awesomeshield/Awesome-Shield-PCB/README.md

# Awesome Shield PCB

This repo is for Awesome Shield hardware development.

## Branches

The branch `unusedVariants` is used to retain version history of variants that have been deprecated.
