awesomeshield/Awesome-Shield-PCB/26fd495.brd.png

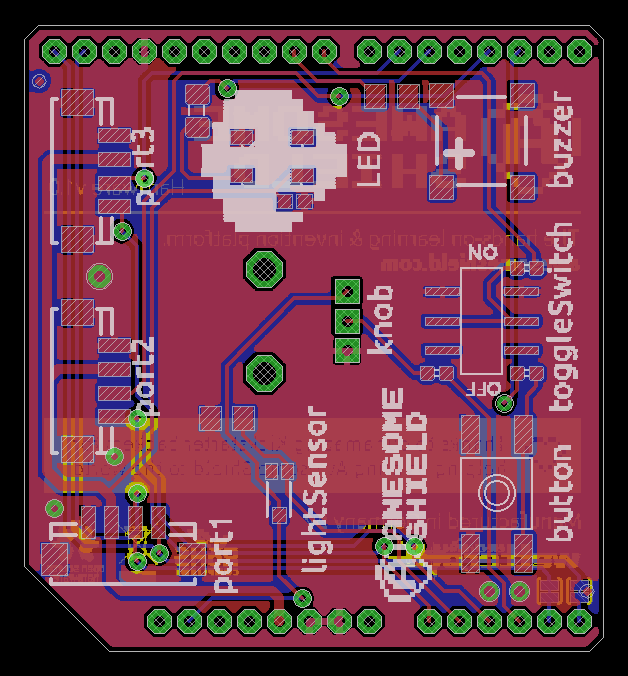
26fd495.brd.png
