awesomeshield/Awesome-Shield-PCB/26fd495.sch.png

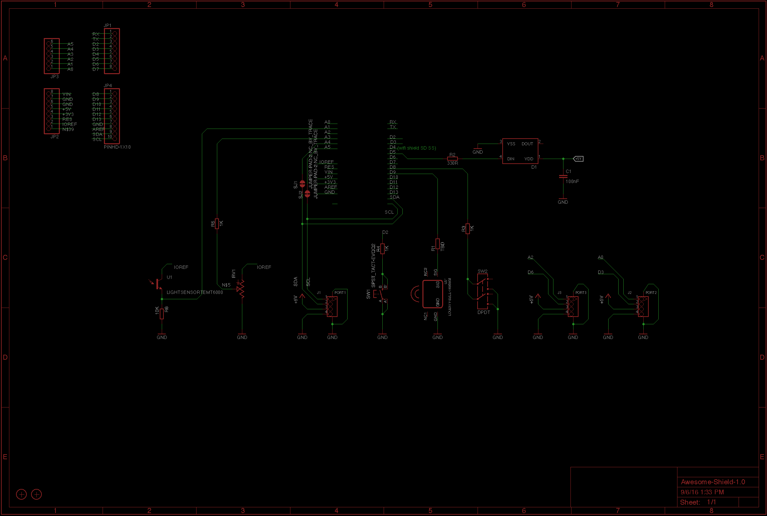
26fd495.sch.png
