awesomeshield/Awesome-Shield-PCB/4577046.brd.png

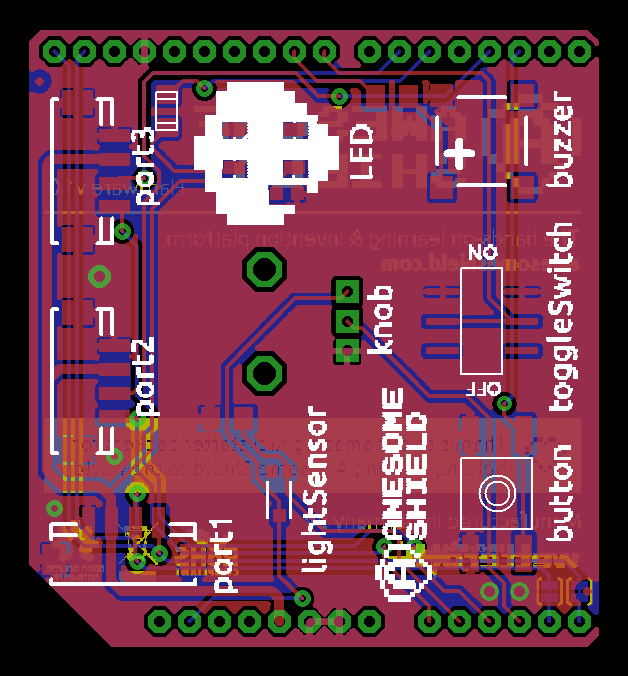
4577046.brd.png
