awesomeshield/Awesome-Shield-PCB/4577046.sch.png

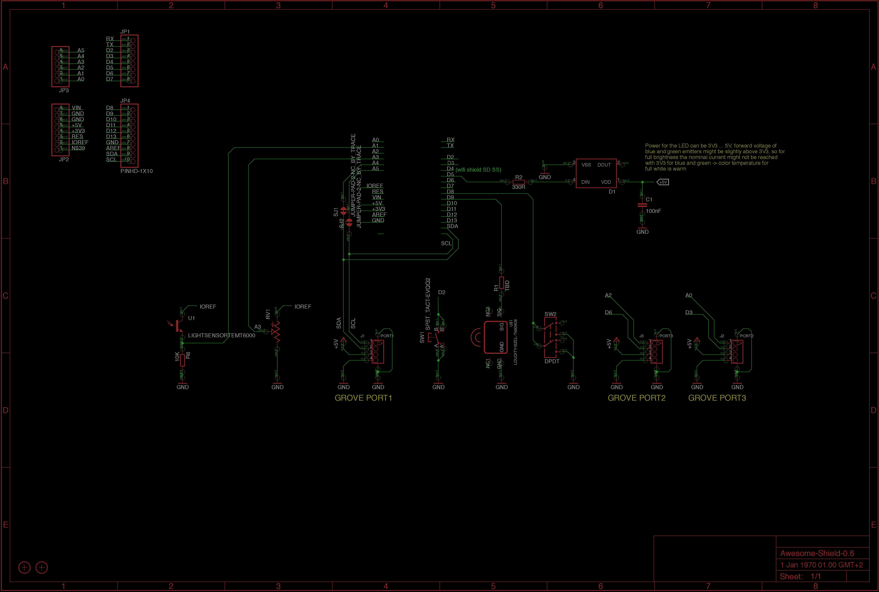
4577046.sch.png
