awesomeshield/Awesome-Shield-PCB/7615891.brd.png

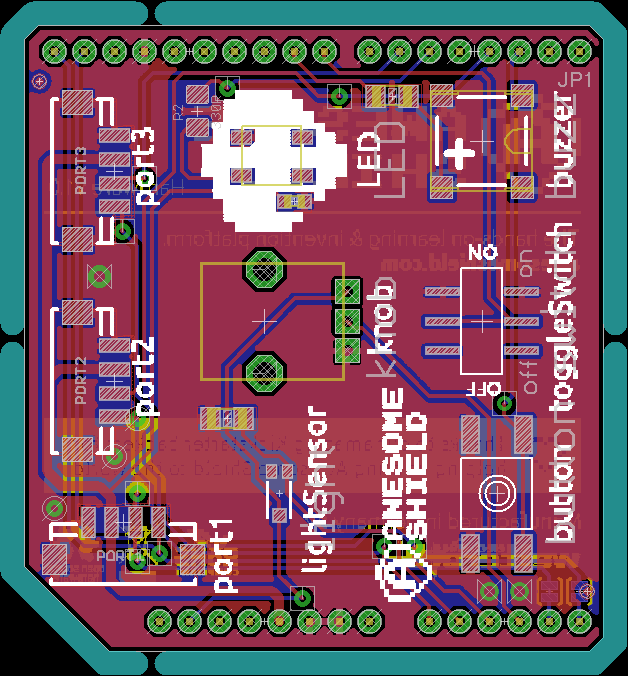
7615891.brd.png
