awesomeshield/Awesome-Shield-PCB/(threads)

Thread 1 (2015-05-11):

Change via shape to round

aShure, 2015-05-11:

cwjpalmer, 2015-05-12:
I've been using a 1mm radius miter to do this. Is that a reasonable turning radius?

aShure, 2015-05-13:
I was thinking about the via pads :) They seem to be squared. You can change the via shape of all the vias simultaneously with the command line.

cwjpalmer, 2015-05-14:
Right! Thanks for clarifying. Somehow I read 'via' as 'trace'. Oops. I'll make sure all the traces are normal straight edges on 45 degree turns, and make sure the vias are all round :-)

cwjpalmer, 2015-05-19:
done.

Closed 2015-05-19.

Thread 2 (2015-05-11):

Add second row of headers right next to the existing ones, with an offset of 100mil

aShure, 2015-05-11:

cwjpalmer, 2015-05-12:
What's the purpose of the headers? Should they be 'straight' aligned, or locking?

aShure, 2015-05-13:
I suggest straight ones, they can then be used to directly solder onto the shield for prototyping OR to populate female headers to accept another shield, while shipping out the product with sturdy and presoldered male headers. Male headers are cheaper and more robust than long stack male-female headers.

cwjpalmer, 2015-05-19:
We're actually leaning towards shipping with male headers, and not including a second row of headers. The rationale is:
- male headers make the components more physically accessible
- the vast majority of our users won't want to solder anything
- if people want to connect up additional components, they can always attach jumpers to the pins on the grove ports
- we want to keep the design simple, and avoid confusing people with stuff they don't need

Closed 2015-05-19.

Thread 3 (2015-05-11):

Run DRC and correct spacing,ie via next to R11

aShure, 2015-05-11:

cwjpalmer, 2015-05-13:
@aShure one DRC error I'm getting a lot is Drill size, one some vias I put into the ground pours to connect them to each other (last time I made a PCB I read that it's good practice to put vias into the ground planes). I used the default drill size for vias (outer diameter=1.0064, drill=0.6).

Questions:
1) should I include vias connecting the ground pours?
2) what size is appropriate?

aShure, 2015-05-13:
Check your net classes, it could be that the power class needs bigger values (which is wrong in this application, but might be the default)

1) Yes
2) same diameter as the holes that are used for the THT headers OR a via diameter that is the maximum which is tented by common PCB manufacturers. Tented via = buried and sealed under solder mask, hole partly or fully bridged by solder mask print.

cwjpalmer, 2015-05-19:
Okay, the spacing issues and other DRC issues are fixed, except for hole sizes on vias.

I'm still looking into tented via sizes, and then I'll update via sizes and make sure the DRC settings correspond. After that, the DRC should be happy :-)

cwjpalmer, 2015-05-20:
I heard back from one potential manufacturer (Seeed) and their max tented hole size is D=0.6mm. Coincidentally, that's what the hole size is currently.

@aShure Could you let me know what German manufacturer you're thinking about using for the first run of 3-4 test PCBS? I'll contact them to see what their max tented via size is. If it's smaller than D=0.6mm, I'll adjust the layout accordingly. If it's D>=0.6mm, I'll keep the vias at D=0.6mm.

Or, if you happen to know this number off hand, that would be cool, too :-)

We're getting close!

aShure, 2015-05-20:
Okay sounds good. 0.6mm sounds big for finished hole size, so I guess it's drill diameter.. I know at least http://www.multi-circuit-boards.eu/ don't guarantee tenting over 300µm finished hole size, so that's after plating.

I suggest https://www.haka-lp.de/ for the first run, please download the DRC file from their homepage and see if everything is okay.
I think Haka have 2mm routing for free but they charge for anything smaller.

cwjpalmer, 2015-05-21:
@aShure Great!

My German is a little rough, so I want to confirm which of haka's DRU files I should use. I'm thinking "zwilling" because leo translates it as "twin". Is that right? Here are their options:

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

aShure, 2015-05-21:
haka_35_l2 and zwilling.

35µm copper, 2 layers and the budget version "zwilling" where you get a
pair of your prototype for a cheaper price if it can be processed in a
stack (hence the bigger diameter and worse tolerances, boards are
stacked and then drilled and routed - the more boards in the stack, the
lower the accuracy)

cwjpalmer, 2015-05-21:
Marvellous. Now the file nomenclature makes sense to me. Thanks for clarifying. And that's good to know about the

I'll run the two DRC sets you mentioned, and make adjustments.

cwjpalmer, 2015-05-21:
**DRC results for haka's haka_35_l2 and zwilling**

all three branches ( `master`, `CPver2`, `CPvar6` ) had two sets of issues across both DRCs:
- solderable jumpers give 9 overlap errors on layer 1
- R9,R10 square arrangement gave 6 keepout errors, as already discussed and approved in issue 11

aShure, 2015-05-28:
The DRC errors are all fine. And yes, you are correct that normal DRC settings are for untented vias. I will inquire about the tented via size.

aShure, 2015-05-28:
Can't reach Haka right now.
Set the tented via size to e.g. 0.6mm - thus the headers won't be tented, but all the vias. If the vias can't be tented in production, they will be altered automatically.

cwjpalmer, 2015-05-28:
Thanks, Alex!

Closed 2015-05-25.

Thread 4 (2015-05-13):

Check clearance for USB and power connector on Arduino motherboard, see if standard (short) male headers are suitable.

aShure, 2015-05-13:
Maybe clear route out the areas where the shield interferes with the motherboard. If possible in a pattern that gives no loss and interlocks two shields head to head, only separated with a 1mm routed path.

cwjpalmer, 2015-05-19:
My approach on this was to make the board a little smaller. Now it shouldn't overlap with the USB or power housings on an Arduino Uno. The new board layout should also work for interlocking head to head.

@aShure one question about interlocking: Right now, the board outline assumes that the centre of the router passes over the centre of the line in eagle on the board outline layer. This puts the angled section of the board outline exactly in the middle of the board, in the Y axis (as in "A" in the diagram). But I think that given the 1mm routed path, this angled section of the board outline should actually be offset by 0.5mm to correctly align 2 boards in the x-direction. Ie. it should be 0.5mm lower on the left hand board orientation, and 0.5mm higher on the right hand side board orientation, as in "B" in the diagram.

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

Does B make more sense to you, too? Are there other factors that I should account for?

aShure, 2015-05-19:
It's correct that the cnc router will ride along the middle of the drawn path as the paths middle is stored numerically as a 2d vector. It's important to choose the right size line width (1mm) for the line because that is passed to the machine as the end mill size.

To me it seems that there is no offset needed if you choose the correct line width. You can verify the design if you a 180 degree rotation around the middle of the slope - the whole board outline has got to be point symmetric around that.

cwjpalmer, 2015-05-19:
Fantastic! So it's scenario A, with the correct line width (1mm). I'll verify by rotation as you've suggested.

cwjpalmer, 2015-05-19:
I checked branch `master`, `CPver2` and `CPvar6` by rotation. They all seem good.

cwjpalmer, 2015-05-19:
@aShure when I changed the route width to 1mm, the DRC had issues with a whole bunch of spacing around the edge of the board. Many things (eg. traces) are easy to fix, but it also had problems with half the pins on the locking headers. Do you recommend that I:

A) only change the interlocking edges between boards to 1mm router width, and leave the the other sides as they were initially
B) change to non-locking headers – it seems like this would fix the problem, but I hope there's a better solution, because the locking headers will make such a big difference during assembly
C) do something else?

Here's a screen shot of A, so you can see what I mean:
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

aShure, 2015-05-19:
The DRC rules might be a tad too conservative, however, after your decision to ditch the stacking headers, it makes sense to use non locking footprints for the male headers. It's a joy to solder them, if they are plugged in another shield or mainboard. The Awesomeshield then just rests on top and is perfectly flat with no strain. So my vote would be B) :+1:

I suggest using the outline layer either on the middle of the path with 1mm width or offset to the inside about 0.5mm and then width a hairline width. In any case, use the *milling* layer and describe the contours there, stick to 1mm width, anything below 1mm as an outline is often just rejected. (some require even 2mm as it is easier to machine and more boards can be stacked!). Don't forget to add tabs, ie interruptions on the path, so that the board won't fall out and crash on the machine, but stay in place in the panel only to be separated after soldering. I suggest 0.5mm tabs at the top left, bottom left, mid right. You have to think about a layout that daisy chains and supports adjacent boards in the panel. Should I draft something to explain it further?

cwjpalmer, 2015-05-20:
Okay, Awesome! I implemented option B in the branches containing our three working versions.

Thanks for the info about the milling layer. It was completely empty. I'll fix that.

cwjpalmer, 2015-05-20:
Re: tab locations, thinking about the board being fit together in pairs, are you thinking tabs at these locations (tabs indicated by notches perpendicular to the outline)?

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

aShure, 2015-05-20:
That is an excellent variant, exactly what I had in mind! If you leave a little space towards the corners (just like you sketched), it's easier to get a clean corner after breaking them apart. Pay special attention that you don't deviate in the X axis with the vertical tabs, as they need to be daisy chained to the adjacent boards on the panel.

cwjpalmer, 2015-05-20:
okay great! so it'll look more like this:

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

aShure, 2015-05-20:
Looks perfect :+1:

cwjpalmer, 2015-05-20:
okay, routing is done, along with tabs.

Closed 2015-05-20.

Thread 5 (2015-05-13):

Place jumpers in a straight line, so they can be cut easily without damaging other traces.

aShure, 2015-05-13:

cwjpalmer, 2015-05-19:
smart!

Closed 2015-05-19.

Thread 6 (2015-05-13):

SDL, SCA, 9, 4... have redundant vias attached. Start route on the target side right away :)

aShure, 2015-05-13:

cwjpalmer, 2015-05-19:
Thanks for the tip! I had always started traces from headers on the top layer. They're a little more strategic now :-)

Closed 2015-05-19.

Thread 8 (2015-05-13):

Route potentiometer to IOREF instead of a fixed power rail

aShure, 2015-05-13:
That is the actual purpose of IOREF, a value of 3.3V won't be a full ADC reading on a 5V Arduino if the pot is fixed to 3.3V max.

aShure, 2015-05-13:
Same might make sense for other parts..

cwjpalmer, 2015-05-19:
I think I should do the same with the thermistor. I'm not sure about the photodiode, though. What do you think @aShure ?

aShure, 2015-05-19:
Yes. Simply all devices that feed into the ADC should have the same voltage output that the controller runs on. Less than the controller's voltage is possible too, but one would lose resolution and a scale in software is needed then.

cwjpalmer, 2015-05-19:
great! I opened a new issue for the other ADC components

Closed 2015-05-19.

Thread 10 (2015-05-19):

A3 is connected to GND instead of potentiometer

aShure, 2015-05-19:
check middle pin of potentiometer, it's NC right now.

cwjpalmer, 2015-05-20:
good catch! I connected A3 to the middle pin of the pot on `master` , `CPver2` , `CPvar6`

@cwjpalmer: remember to update this on `issue11` if merging that branch into main

cwjpalmer, 2015-05-20:
@aShure do you think I should connect the large mounting holes to GND, or leave them as NC?

aShure, 2015-05-20:
Connecting to GND is fine, use thermals to make it easy to solder - lots of thermal mass.
On 20/05/2015 4:14 pm, Chris Palmer <notifications@github.com> wrote:@aShure do you think I should connect the large mounting holes to GND, or leave them as NC?

—Reply to this email directly or view it on GitHub.

cwjpalmer, 2015-05-20:
@aShure I'm having a bit of a tough time getting eagle to connect those pads to the GND net. Is there any reason not to leave them NC (as they are now, and as the part in the Sparkfun library is configured)? If there's nothing bad about leaving them as is, I'll do that.

aShure, 2015-05-20:
No problem just leave them like that. FYI for future endeavors: If you
can't manage to connect the pin in the library part, you can always
route a wire with the GND net (use the name command) to a pin manually
as a hack and ignore the DRC error for that pin then.

cwjpalmer, 2015-05-21:
Great! I'll leave it, and that's a really good trick to know. Thanks for sharing the tip :-)

Closed 2015-05-21.

Thread 11 (2015-05-19):

rearrange R3,4 and R9,10 so that one single part can be used too

aShure, 2015-05-19:
Two resistors can be bridged if they are placed in a way that all of their four pads are in a regular square pattern. That way one can either use two in series or just one part, with half the resistance.

cwjpalmer, 2015-05-20:
I think I understand. I'll give it a try, and you can let me know if I did it correctly.

cwjpalmer, 2015-05-20:
Okay, I gave this a try in the branch `issue11` https://github.com/cwjpalmer/Awesome-Shield-PCB-0.5/tree/issue11

@aShure Is this what you had in mind? If so, let me know and I'll merge this back into master, and make similar changes in the other two working variants.

Some things that I noticed that might be problematic:
1. the spacing of the 0603 resistors (R9,10) now violates the DRC (in order to put the pads in the square arrangement)
2. the pads for the resistors aren't square. So although they're arranged in a square, if you tried to solder a single resistor between the two sets of pads (to avoid using 2 in series) I think that part of the resistor would land on solder mask. You can see what I mean by copying a resistor, rotating it 90 degrees, and holding over the two pads, where you would solder it.

aShure, 2015-05-20:
I am sure that the 1206 resistors will fit either way even if the pad is designed for reflow and not square. I guess you're onto something with the 0603 pads being not square. Does the DRC complain about the tRestrict layer with the 0603 parts or is it something else?
On 20/05/2015 12:56 pm, Chris Palmer <notifications@github.com> wrote:Okay, I gave this a try in the branch issue11 https://github.com/cwjpalmer/Awesome-Shield-PCB-0.5/tree/issue11

@aShure Is this what you had in mind? If so, let me know and I'll merge this back into master, and make similar changes in the other two working variants.

Some things that I noticed that might be problematic:
1. the spacing of the 0603 resistors (R9,10) now violates the DRC (in order to put the pads in the square arrangement)
2. the pads for the resistors aren't square. So although they're arranged in a square, if you tried to solder a single resistor between the two sets of pads (to avoid using 2 in series) I think that part of the resistor would land on solder mask. You can see what I mean by copying a resistor, rotating it 90 degrees, and holding over the two pads, where you would solder it.

—Reply to this email directly or view it on GitHub.

cwjpalmer, 2015-05-20:
That's great to know about the 1206 resistors. About the 0603 ones: the DRC complains about the tKeepout layer (39). Here's a screenshot:

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

aShure, 2015-05-20:
That's enough space for my taste, I did closer than that with Avoccado°.
The 0603 wouldn't be assembled manually anyways. One might push R9 away
with the tweezers while setting R10 with manual placement.

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

cwjpalmer, 2015-05-20:
Fantastic! So then it seems like I should incorporate what you see above (the resistor layout changes made in branch `issue11` into the 3 working variants. Does that makes sense to you? Currently, the square resistor layout is only present on branch `issue11`.

aShure, 2015-05-20:
Sure.
When I had a look at the branches it was not clear to me what the
differences are. Mind you I only took a quick glance at the
repositories, the branch names or READMEs where not explanatory to me. I
think you might be doing redundant work if you alter all branches
separately and might be faster off with sticking to one or two.

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

cwjpalmer, 2015-05-20:
Ya, I don't think I'm in a very efficient workflow. The three branches (master, CPver2, CPvar6) are three different layouts so that we can try different possibilities for UX with components in different places. I should have done one version, got you to check it, fixed all this stuff we're working through now, and then created the variants, I think. Now I know for next time :-)

cwjpalmer, 2015-05-20:
okay, all three variants now have the right resistor layouts for the R3,4,9,10

Closed 2015-05-20.

Thread 12 (2015-05-20):

Add missing data sheets

cwjpalmer, 2015-05-20:
they're all linked in the part packages, but should be in the `/datasheets` directory as PDFs

cwjpalmer, 2015-05-29:
I'm working on the BOM on octopart:
https://octopart.com/bom-lookup/NXcyO8GW

Datasheets are included there.

Closed 2015-05-29.

Thread 13 (2015-05-20):

Add fiducials

aShure, 2015-05-20:

aShure, 2015-05-22:
nudge the fiducials onto the grid, micro fiducials should align with the components' mid points. This is unresolved as of now, as some components are not placed on the grid.

aShure, 2015-05-22:
correct placement shall be finished by @cwjpalmer :-)

cwjpalmer, 2015-05-23:
will do!

cwjpalmer, 2015-05-23:
@aShure just to clarify, can you please confirm or correct this stuff? :
1. Macro fiducials should be on mm grid, near where you put them
2. Micro fiducials should be on mm grid, at midpoints of components
2b. Question: do only SMD / machine placed components need micro fiducials?
3. Should fiducials not overlap with silkscreen, or does that matter?

aShure, 2015-05-23:
1. Yes
2. Local component fiducials are not always necessary, but as there's so much space I placed them at the odd shaped components. Midpoint or one edge or three outer edges are common practice.
None of the components actually need them on this board.
Yes, metric grid please when possible - most probably that will not be the case for the mid point.

Fiducials should be free of silkscreen and solder mask, just bare copper with an annulus of nothing around them, the more space the better.

cwjpalmer, 2015-05-23:
Thanks! That was really clear and really helpful :-)

cwjpalmer, 2015-05-23:
Okay, I think it's done correctly in commit `7b772e0cbf31359f01a4ac244fdb73c1b373331e`

Closed 2015-05-23.

Thread 14 (2015-05-22):

Toggle Switch Pads

cwjpalmer, 2015-05-22:
@aShure I added 1mm to the outside edges of the toggle switch pads to make hand soldering easier. Initially the pads were exactly the same as the landing area of the feet. Do you think this will be okay for reflow, in terms of surface tension pull to one side or the other if there's an uneven heat distribution?

aShure, 2015-05-28:
It will be if you remove the thermals from the pads (uncheck Thermals at the part level) and route the GND wires manually, normal to the pads

aShure, 2015-05-28:
I just tried that and reversed it again. I think it doesn't make a difference at all because of the soldermask surrounding all the pads.

Closed 2015-05-28.

Thread 15 (2015-05-22):

Use vector font to give reliable result after gerber renderings

aShure, 2015-05-22:

cwjpalmer, 2015-05-23:
fixed in commit  `90f41782846afeb44a30a8f5622f74edbecd028e`

Closed 2015-05-23.

Thread 16 (2015-05-22):

fix milling layer to new lower real estate outline

aShure, 2015-05-22:

cwjpalmer, 2015-05-23:
done in commit `d52753dfb987454f5debca608f7b1bc4a614aa07`

Closed 2015-05-23.

Thread 19 (2015-05-24):

height should be 53 or 52, makes it easier to panelize

aShure, 2015-05-24:

aShure, 2015-05-24:
width should be reduced to 49, there's redundant space on both sides. I would take it away from the right side.
Just an example:
with a board spacing of 1mm and a width of 100mm per panel, the board better be less than 49.5mm. For a 2mm router bit, it would need to be no bigger than 49mm. If scaling up to more than just two boards in a row, each iteration should occupy no more than a 50mm including the milling bit width.

There might be space for 48mm..

cwjpalmer, 2015-05-25:
height is at 53mm, board outline is on mm grid as of commit `d2fe7ea03bfe87debf3c3968f5a6bcddb1743020`

cwjpalmer, 2015-05-25:
adjusted board width to 49mm in commit `23dbb87129958a432bd4e2d01da165933cc024d0`

@aShure there's not much substrate left between the top row of header holes (ca. 1.7mm between the outside holes and the edge of the board). Do you think that's okay? Do you think we can change the width to 48mm and still maintain strength? This would mean ca. 1.5mm from holes to the edge of the board.

aShure, 2015-05-28:
Yes that is enough. Scroll down at https://github.com/avoccado/avoccado-pcb-avr to see various examples of just <1.5mm hole to outline spacing

cwjpalmer, 2015-05-28:
Awesome! Thanks! Also, those are some gorgeous layout! I think I'm only beginning to appreciate the beauty of the engineering, but they're also visually stunning images.

Closed 2015-05-28.

Thread 20 (2015-05-24):

add silkscreen for resistor values

aShure, 2015-05-24:
don't use their names for the silkscreen, use their values. put them on tPlace.

cwjpalmer, 2015-05-25:
done as of commit `d8f06583e7917c512c09038e06807239232a6a9e`

Closed 2015-05-25.

Thread 21 (2015-05-24):

Insufficient Space around 4pin ports and buzzer for soldering

cwjpalmer, 2015-05-24:
Move the Analog In silkscreen to the left (edit part in library), to make room to move 4pin ports down. This will make more space between the buzzer and the ports, which will make soldering easier.

cwjpalmer, 2015-05-25:
done in commit `bf3f8416c4fb4b99f4f7e614d3c73c65654bae1e`

Closed 2015-05-25.

Thread 22 (2015-05-27):

75 Ohms resistors as current limiters are too low

aShure, 2015-05-27:
worst case for red:
(5V-1.8V) / 2 x 75 Ohms = 0.022 A

That's above the spec of the LED and the portpins, if the shield should be compatible with the newest Arduinos. The Arudino Due can only use certain portpins with more than 3mA, the new Arduino Zero runs on 3.3V and has got a lower current capability than the Uno.

"DC Current per I/O Pin	7 mA" (http://www.arduino.cc/en/Main/ArduinoBoardZero)

Some LEDs are run at less than 1mA, like the status LEDs on the normal Arduino boards. There's no need to use 20mA, 7mA will be bright.

I guess there need to be different resistor values if you want to have the same brightness for 5V and 3.3V motherboards.

cwjpalmer, 2015-05-27:
Good catch!

I redid the calculations for the 5V @ 7mA, and got 330 Ohm resistors. Here are my worst case calculations:
red:
(5V-1.8V) / 2 x 330 Ohms = 4.8mA
green and blue:
(5V-2.8V) / 330 Ohms = 6.7mA

And at 3V3:
red:
(3.3V-1.8V) / 2 x 330 Ohms = 2.3mA
green and blue:
(3.3V-2.8V) / 330 Ohms = 1.5mA

Which I guess will be dimmer, but still fine, as you pointed out that  < 1mA would be okay.

I've updated the resistor values in eagle in commits `master – b5265fd21d6b22c6ef18f395876f5d5a0203b2bf ` and `rightSideUI – a9772cc1788059bfb65202da16813fd8abb637ed `

aShure, 2015-05-28:
You can decrease the resistance a bit, as 3.3V and 7mA is for the new Arduinos, all the old ones run at 5V and can supply something like 20-40mA. So I would spec it at 7mA at 3.3V and 20mA at 5V, whichever gives the highest resistance.

cwjpalmer, 2015-05-28:
Brilliant!

cwjpalmer, 2015-05-28:
Okay, resistor specs are updated!

I arrived at 130 +/- 5% Ohm resistors. This means lowest possible resistors should be 123.5 Ohm, and:

3V3, 7mA red:
I = (3.3-1.8)V / (2 x 123.5Ohm) = 6.1mA
*6.1mA < 7mA*

3V3, 7mA green, blue:
I = (3.3-2.8)V / (123.5Ohm) = 4.0mA
4.0mA < 7mA

5V, 20mA red:
I = (5-1.8)V / (2 x 123.5Ohm) = 13mA
13mA  < 20mA

5V, 20mA green, blue:
I = (5-2.8)V / (123.5Ohm) = 18mA
*18mA < 20mA*

These values are updated in commits:
master – 91ba2e49fd83367d4ef821892daf04396256fdae
rightSideUI – ff7fc9ccc651946b41404483b5a3b1b7c972cac0

Closed 2015-05-28.

Thread 23 (2015-05-27):

add final git commit hashes to bottom silkscreens

cwjpalmer, 2015-05-27:

cwjpalmer, 2015-05-27:
And also the version numbers. One should be "0.50" and the other should be "0.51". They're both currently "0.5x"

cwjpalmer, 2015-06-09:
done as per naming in readme

Closed 2015-06-10.

Thread 24 (2015-05-27):

Parts In Stock

cwjpalmer, 2015-05-27:
Make sure parts are in stock with a supplier that can deliver quickly, in small quantities, and are also available at very large scale.

cwjpalmer, 2015-05-29:
BOM created in octopart, and linked from readme. Parts are available @ volume of 25 devices (25x complete BOM) from a combination of TME + digikey.

https://octopart.com/bom-lookup/NXcyO8GW

Closed 2015-05-29.

Thread 25 (2015-05-28):

Silk screen resistor labels

cwjpalmer, 2015-05-28:
line and text likely to melt together, as described in
https://github.com/cwjpalmer/Awesome-Shield-PCB-0.5/commit/a2bf2918c8b88c4840163a28a1e64a8655d3224b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

cwjpalmer, 2015-05-28:
I adjusted this in commits:
master – 741b3efe7c338eff0eea3412ebe700c834f3572a
rightSideUI – 1b4e61492ab28f9da07e4cb8e1fd9187943c8af7

Closed 2015-05-28.

Thread 26 (2015-05-28):

left tab missing on milling layer

aShure, 2015-05-28:

cwjpalmer, 2015-05-28:
the right tab was also a tiny bit of centre. Fixed both these things in commits:

master
e66b66acd4b0974905aa712cadad06d3ce7a9b5c

rightSideUI
9e4f89f1d39a2db188da6d03ad806ad9d0a0123f

Closed 2015-05-28.

Thread 27 (2015-05-28):

Validate that the buzzer is compatible for the new Arduino models

aShure, 2015-05-28:
Due to the current and voltage changes at the portpin levels of the new Arduinos, a current limiting resistor might be needed in a future proof design.

cwjpalmer, 2015-05-28:
As far as I can tell, buzzers have a coil resistance. To find this, I used the operating specs from the datasheet (http://www.tme.eu/en/Document/565faa25e36aa0e6e3f4693c6906e818/BZ-25SMD.pdf)

5V, 1.5mA

R = V / I = 5V / ( 1.5 / 1000 A) = 3.3K Ohm

Then using 3V3, for the new Arduinos to find current:

I = V / R = 3.3V / 3300 Ohm = 1mA
1mA < 7mA

So I think we should be okay.

One source mentioned that there's a difference between buzzers, and piezoelectric transducers. They said that piezoelectric transducers have a resistance that is ususally listed on the datasheet. The datasheet for our buzzer doesn't say it's a piezo transducer, or list a resistance. I'm going to look into this more.

aShure, 2015-05-28:
No need to, that sounds solid!
On 28/05/2015 5:45 pm, Chris Palmer <notifications@github.com> wrote:As far as I can tell, buzzers have a coil resistance. To find this, I used the operating specs from the datasheet (http://www.tme.eu/en/Document/565faa25e36aa0e6e3f4693c6906e818/BZ-25SMD.pdf)

5V, 1.5mA

R = V / I = 5V / ( 1.5 / 1000 A) = 3.3K Ohm

Then using 3V3, for the new Arduinos to find current:

I = V / R = 3.3V / 3300 Ohm = 1mA
1mA < 7mA

So I think we should be okay.

One source mentioned that there's a difference between buzzers, and piezoelectric transducers. They said that piezoelectric transducers have a resistance that is ususally listed on the datasheet. The datasheet for our buzzer doesn't say it's a piezo transducer, or list a resistance. I'm going to look into this more.

—Reply to this email directly or view it on GitHub.

cwjpalmer, 2015-05-28:
great! thanks for the feedback :-)

Closed 2015-05-28.

Thread 28 (2015-05-30):

Pick New LED?

cwjpalmer, 2015-05-30:
I've been looking at parts stocks, and I'm not finding a ton of inexpensive RGB LEDs in 5050 packages that are extremely well stocked. I'm worried about having to pick a new LED in the future, due to unavailability. ie. the LED we found at TME is actually only available from TME, as far as I can tell. They have 4k in stock, but if that dries up, we need to source an alternate. Octopart page for the part:
https://octopart.com/ww-fce50tc-q1-wah+wang-51862286

My approach in looking at the other parts on the BOM has been to try to make sure we have easy, drop in replacements, from multiple suppliers, in varying quantities. This is tough with LEDs because their power requirements and footprints are so variable. Perfect drop in replacements aren't easy for me to find.

I'm wondering if we wouldn't be better of switching to a different package type that has broad and cheep availability of LEDs.

cwjpalmer, 2015-05-30:
This lite-on LED, seems like an appealing alternative. It's a very small package, though (1.6x1.6mm) https://octopart.com/search?q=LTST-C19HE1WT&view=list&start=0#_

aShure, 2015-05-30:
I found quite a lot of SMD RGB LEDs in the 5050 package at other suppliers, see here: http://www.digikey.com/product-search/en/optoelectronics/led-indication-discrete/524729?k=5050%20RGB

5050 packages are a mass produced industry standard, used a lot in LED strips.

It won't be a problem to use a different brand and model if the 5050 footprint is similar.You can have a look at other PLCC6 packages in smaller sizes. PLCC6 is the general term for those LED packages with six feet. 5050 is the biggest, usually brightest one. Another one would be 3528 or smaller. The four digits declare the XY size of the package, 5050 equals 5.0 x 5.0 mm²

The Liteon LED you linked there comes in a 1616 package. I'd prefer the 5050.

cwjpalmer, 2015-06-09:
sticking with the 5050

Closed 2015-06-09.

Thread 30 (2015-07-17):

GND via placement 0.50 LHS

cwjpalmer, 2015-07-17:
There's GND via on the left hand side of V0.50 between the SCL trace and the edge of the board. The pad from the via goes outside the GND pour, so it may be too close to the edge of the board. Check Seeed's specs, and see if it's okay.

Possible solutions:
- decrease pad diameter
- move neighbouring traces to make space

cwjpalmer, 2015-07-19:
Fixed on unpanelized V0.50 in commit `aed75686ee1254fed4a195069a659c31cab7a090`

cwjpalmer, 2015-07-19:
fixed on panelized version in commit `ffb45354043ad86a1897d4cdb3456cb270e78990`

Closed 2015-07-19.

Thread 31 (2016-02-08):

White Spot Around LED

cwjpalmer, 2016-02-08:
Suggest putting a solid shape around the LED in the silkscreen. This was the colors of the LED will be more visible. Especially red, which is has very weak contrast agains the red solder mask.

Closed 2016-07-24.

Thread 32 (2016-07-01):

LED Orientation

cwjpalmer, 2016-07-01:
The fiducial and silk screen mark for pin 1 on the LED are next to pin 6, not pin 1. Maybe the LED part was created incorrectly. This should be fixed so that the fiducial and mark align with the marked corner on the package.

LED package correct (working) orientation:
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

silk screen mark and fiducial
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

[LED data sheet, with pin numbering](http://www.tme.eu/en/Document/a31e66413e4f51e9e36df8dd367f5ab5/WW-FCE50TC-Q1.pdf)

Closed 2016-07-24.

Thread 33 (2016-07-01):

Use 5V instead of IOREF

cwjpalmer, 2016-07-01:
I think it would be better to use the 5V pin to supply power to the potentiometer and the photodiode, rather than the IOREF pin.

aShure, 2016-07-06:
Why do you think it would be better?

cwjpalmer, 2016-07-08:
@aShure My thinking is that it's a good idea to keep the IOREF pin unused so that people can use it to adjust the IO reference voltage if they want. Is there an advantage to using it over the 5V to supply power to the analog components?

Maybe using the AREF pin to supply power to the analog components is actually a better way to go? That way if you change the AREF voltage you're using, you still get a full range of readings from the analog components.

aShure, 2016-07-08:
The IOREF pin can't be adjusted by the user, it is exactly for this purpose, to have a full scale reading on the ADC. The IOREF pin signals to the shield what kind of host board is used.

Using 5V hardwired is not a good idea because host boards might run on 3V3.

aShure, 2016-07-08:
The AREF pin is meant to be used as an input, not a reference output. Different application.

cwjpalmer, 2016-07-08:
Okay great! Thanks @aShure I misunderstood, and it sounds like we should keep using the IOREF pin.

Closed 2016-07-08.

Thread 35 (2016-07-04):

Component Labeling on Silk Screen

cwjpalmer, 2016-07-04:
Components (excluding resistors and headers) should have enough space next to them for labels. Space for labels should be on the side closest to the end of the board that pin 0 and pin A5 are on on an Arduino Uno pinout. The photodiode resistor should be placed far enough from spaces that labels will be in to avoid ambiguity of any labels.

4 pin connectors ("Grove ports") should have enough space around them for either a label or a shape to be drawn around them on the silk screen.

cwjpalmer, 2016-07-08:
@aShure FYI the font we're going to use for component labels on the silk screen will be the summer font, which you can see in the Awesome Shield styleguide http://awesomeshield.com/styleguide (it's the H1 font). I'm pointing this out because it's pretty tall and skinny, so the aspect ratio will effect the component spacing.

cwjpalmer, 2016-07-08:
Here's a sample graphic that has the component names in the correct font.

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

aShure, 2016-07-24:
Needs to be done after the E-CAD, Eagle can't render fonts. It's also horrible at dithering/aliasing/interpolating anything.
I suggest submitting Eagle sources plus rendered masks (export form Eagle, modify with graphic editor) to manufacturer.
Tipp: Use the top, bottom and guide layers as low opacity overlays when working on the silkscreen design in a graphic editor, makes it easy to spot collisions like vias.

cwjpalmer, 2016-08-01:
added bitmap top silkscreen in V0.60 release

Closed 2016-08-01.

Thread 36 (2016-07-04):

Buzzer Between LED and Photodiode

cwjpalmer, 2016-07-04:
The buzzer should be placed between the LED and photodiode. This is so that the buzzer mitigates the influence of the LED on the photodiode reading.

Closed 2016-07-24.

Thread 38 (2016-07-25):

Via too close to pad?

cwjpalmer, 2016-07-25:
There's a via next to one of the pads for port 2. The via's pad is within the solder mask pull-back area of the port's pad. Ie. there will be exposed copper from the via right next to the port. I don't think this is an issue since the via is routed to the pad. But it seemed unusual so I'm pointing it out just in case.
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

aShure, 2016-07-25:
that looks fine. via-in-pad is sometimes default for BGA assemblies :) you can make the via smaller or the restring smaller or move the via if you want!

Closed 2016-07-25.

Thread 39 (2016-07-25):

GND via close to trace

cwjpalmer, 2016-07-25:
There's a GND via less than one trace-width away from a trace. It's the via that's right next to port 1.
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

aShure, 2016-07-25:
Good catch, I'll move it. It's within the design rules (the isolation distance is enough) so I didn't catch it.

cwjpalmer, 2016-07-25:
Thanks! 👍

Closed 2016-07-25.

Thread 40 (2016-07-25):

Router track should be continuous

cwjpalmer, 2016-07-25:
There are currently breaks in the router path to create tabs for panelization. I think that this should be added layer by the manufacturer. I think for now, we should show a continuous routing path around the edge of the board. What do you think @aShure ?

aShure, 2016-07-25:
Finished files should contain no milling layer at all (each layer is a separate file anyways, so it's ok to keep it in the source file for now if you want to mill a prototype yourself, for example in the fablab berlin). Just the dimension layer is important.
Ask the manufacturer if they build the panel or have a template at hand and if they want to have a milling layer. It's also their call what end mill to use. Liteon, Andus etc might charge extra for milling with small end mills. Usually a stack of boards is milled and drilled at once. For small end mills the stack can't be as high, so each and every panel is milled separately with a slower speed -> extra cost.

cwjpalmer, 2016-07-25:
👍  @aShure Thanks! That's really good to know.

Closed 2016-07-25.

Thread 43 (2016-08-07):

Add Pin Number to Silk Screen

cwjpalmer, 2016-08-07:
So that people can easily identify which pins they can wire components up to, and what corresponding pin numbers they should use in their code.

cwjpalmer, 2016-09-02:
We decided not to. Here's why:

- visual space on PCB makes labels much clearer and easier to read
- we're shipping this hardware with Genuino Uno, which has pin labels on the side of the headers, as do most modern Arduino / Genuino boards.

Closed 2016-09-02.
