awesomeshield/Awesome-Shield-PCB/Awesome-Shield-1.0.brd

## EAGLE design Awesome-Shield-1.0.brd (2016-10-31)

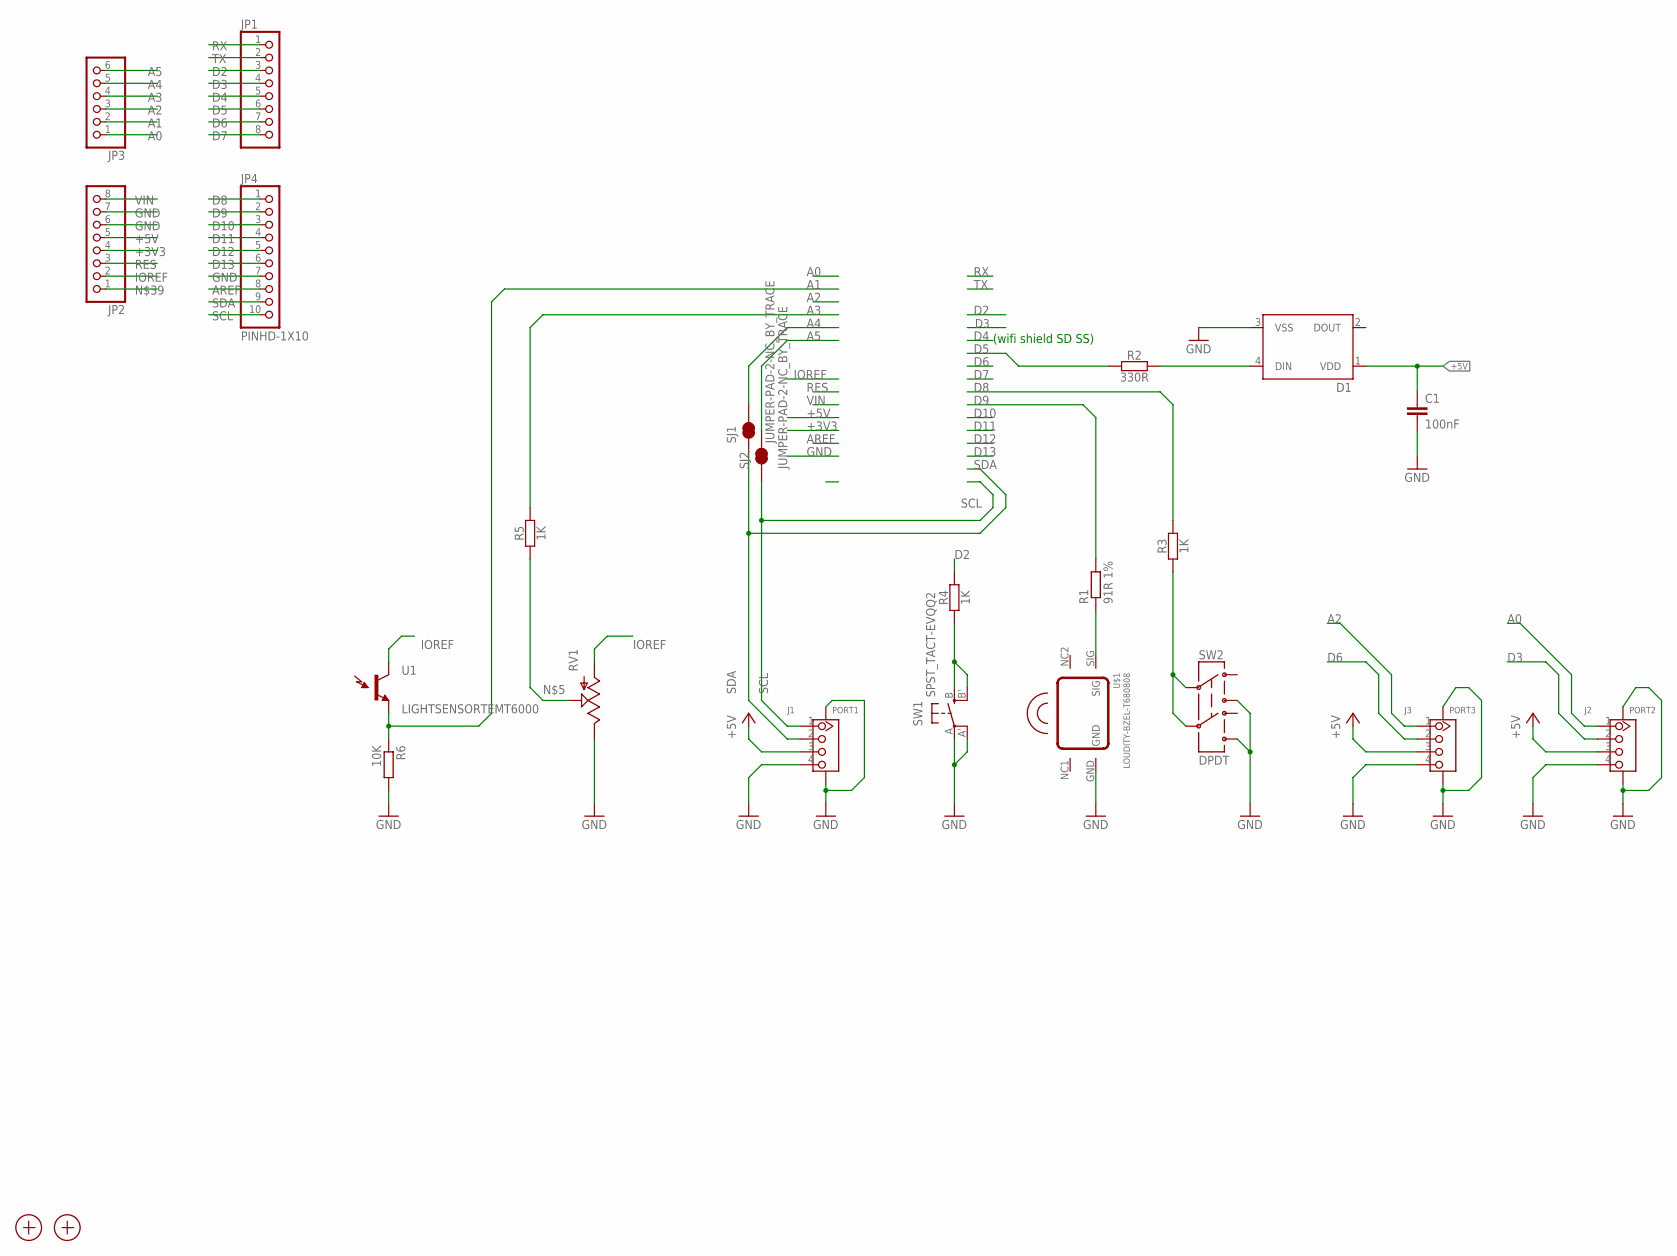
[picture p7: schematic Awesome-Shield-1.0.sch]

Parts:
C1: 100nF; C0603
D1: WS2812B
J1: PORT1; HW4-SMD-2.0
J2: PORT2; HW4-SMD-2.0
J3: PORT3; HW4-SMD-2.0
JP1, JP2: PINHD-1X8CLEANBIG; 1X08-CLEANBIG
JP3: PINHD-1X6CLEAN; 1X06-CLEAN
JP4: PINHD-1X10; 1X10-BIG
R1: 91R 1%; R1206
R2: 330R; C1206
R3, R4, R5: 1K; C0603
R6: 10K; R1206
RV1: POT; ALPS_POT
SJ1, SJ2: JUMPER-PAD-2-NC_BY_TRACE; PAD-JUMPER-2-NC_BY_TRACE_YES_SILK
SW1: SPST_TACT-EVQQ2; EVQ-Q2
SW2: DPDT; AYZ0202
U1: LIGHTSENSORTEMT6000; TEMT6000-SEN
U$1: LOUDITY-BZEL-T680808; SMT-68
X1, X2: PASSER-07; PASSER_07MM

Connections:
+3V3: JP2.4
+5V: C1.1, D1.1 (VDD), J1.3, J2.3, J3.3, JP2.5
A0: J2.1, JP3.1
A1: JP3.2, R6.1, U1.EMITTER (E1)
A2: J3.1, JP3.3
A3: JP3.4, R5.2
A4: JP3.5, SJ1.2
A5: JP3.6, SJ2.2
AREF: JP4.8
D2: JP1.3, R4.2
D3: J2.2, JP1.4
D4: JP1.5
D5: JP1.6, R2.1
D6: J3.2, JP1.7
D7: JP1.8
D8: JP4.1, R3.2
D9: JP4.2, R1.2
D10: JP4.3
D11: JP4.4
D12: JP4.5
D13: JP4.6
GND: C1.2, D1.3 (VSS), J1.4, J1.SS1, J1.SS2, J2.4, J2.SS1, J2.SS2, J3.4, J3.SS1, J3.SS2, JP2.6, JP2.7, JP4.7, R6.2, RV1.P$1 (E), SW1.A, SW1.A' (P1), SW2.3, SW2.6, U$1.GND
IOREF: JP2.2, RV1.P$3 (A), U1.COLLECTOR (C1)
unnamed: R1.1, U$1.SIG
unnamed: D1.4 (DIN), R2.2
unnamed: R3.1, SW2.2, SW2.5
unnamed: R5.1, RV1.P$2 (S)
unnamed: R4.1, SW1.B (S), SW1.B' (S1)
RES: JP2.3
RX: JP1.1
SCL: J1.1, JP4.10, SJ2.1
SDA: J1.2, JP4.9, SJ1.1
TX: JP1.2
VIN: JP2.8

Notes on the sheet:
(wifi shield SD SS)

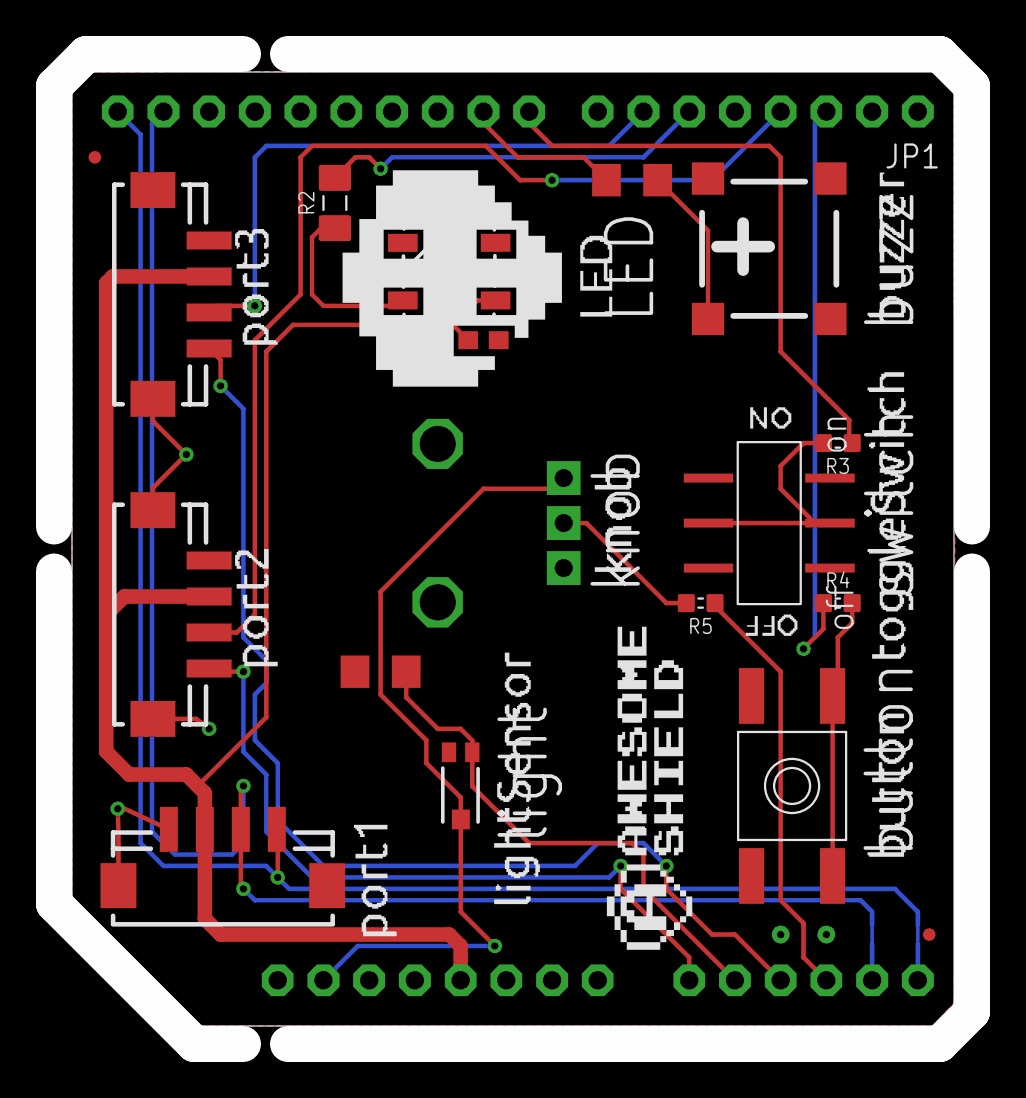
[picture p8: board Awesome-Shield-1.0.brd from above]

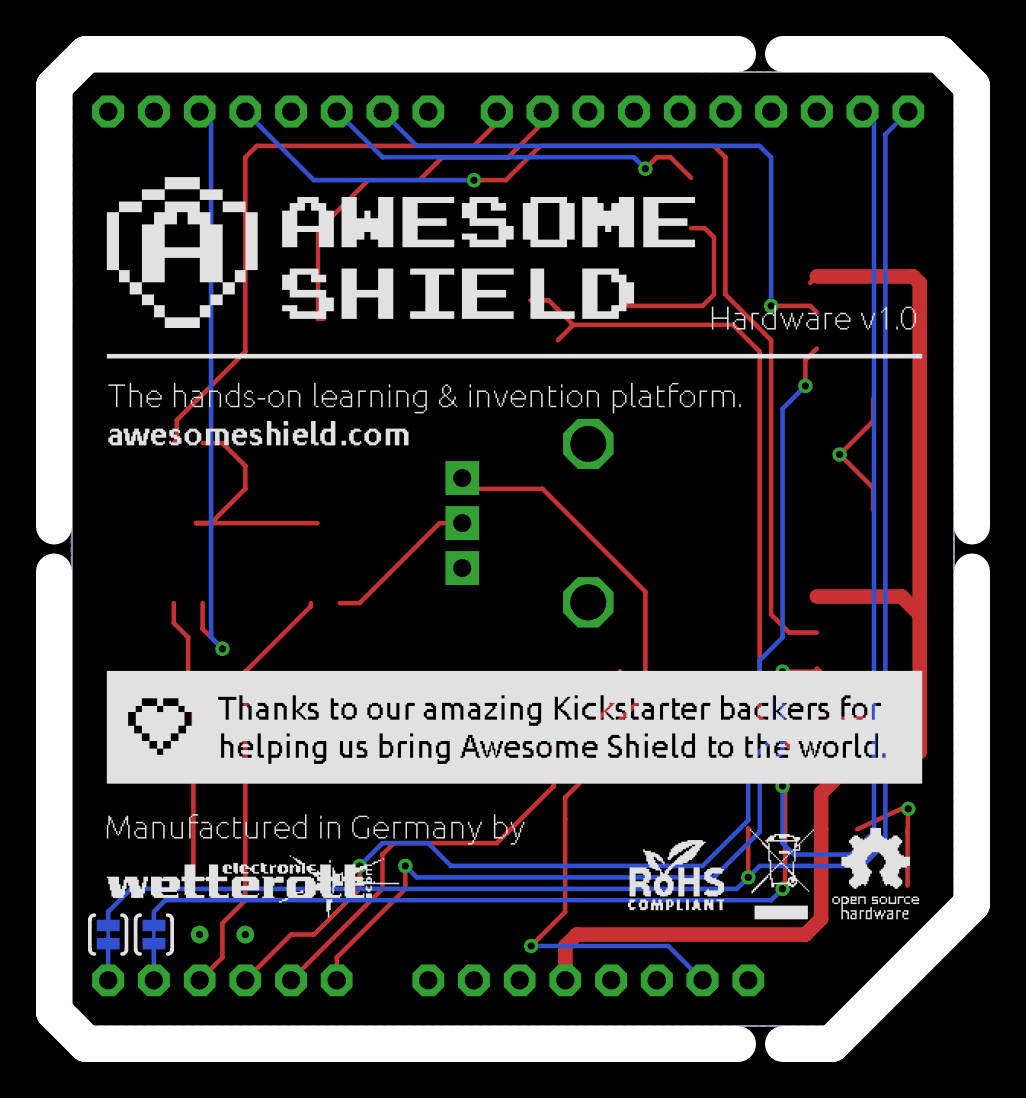
[picture p9: board Awesome-Shield-1.0.brd from below]

Board: 2 copper layers, 51.0 x 55.0 mm, 24 parts (2 on the bottom side), 22 nets.
