awesomeshield/Awesome-Shield-PCB/(commit log)

2015-05-02 init, added most components
    [Awesome-Shield-0.5.sch]
2015-05-02 layout tweaks
    [Awesome-Shield-0.5.sch]
2015-05-02 addded grove ports, began layout
    [Awesome-Shield-0.5.brd, Awesome-Shield-0.5.sch]
2015-05-03 tweaked layout
    [Awesome-Shield-0.5.brd]
2015-05-03 swapped RGB LED pins to avoid crossing traces
    [Awesome-Shield-0.5.brd, Awesome-Shield-0.5.sch]
2015-05-03 cleaned up schematics, reselected digital grove connector pins
    [Awesome-Shield-0.5.brd, Awesome-Shield-0.5.sch]
2015-05-03 added 3rd grove port
    [Awesome-Shield-0.5.brd, Awesome-Shield-0.5.sch]
2015-05-03 changed grove ports to SMT
    [Awesome-Shield-0.5.brd, Awesome-Shield-0.5.sch]
2015-05-03 placed grove ports in layout, added A4 A5 SCL SDA jumpers in schematic
    [Awesome-Shield-0.5.brd, Awesome-Shield-0.5.sch]
2015-05-03 added switch -NC, moved RGB LED group
    [Awesome-Shield-0.5.brd, Awesome-Shield-0.5.sch]
2015-05-03 moved jumpers SDA SCL nets from A4 A5 nets
    [Awesome-Shield-0.5.brd, Awesome-Shield-0.5.sch]
2015-05-03 removed 3rd grove port, changed grove port pins
    [Awesome-Shield-0.5.brd, Awesome-Shield-0.5.sch]
2015-05-04 added dummy buzzer
    [Awesome-Shield-0.5.brd, Awesome-Shield-0.5.sch]
2015-05-04 adjusted tact switch and buzzer landing areas, moved jumpers to A4 and A5 traces
    [Awesome-Shield-0.5.brd, Awesome-Shield-0.5.sch]
2015-05-04 switched jumpers to cutable traces
    [Awesome-Shield-0.5.brd, Awesome-Shield-0.5.sch]
2015-05-04 placed cutable trace jumpers
    [Awesome-Shield-0.5.brd]
2015-05-04 redid toggle switch landing areas
    [Awesome-Shield-0.5.brd, Awesome-Shield-0.5.sch]
2015-05-04 adjusted layout
    [Awesome-Shield-0.5.brd]
2015-05-05 removed extraneous buzzer
    [Awesome-Shield-0.5.brd, Awesome-Shield-0.5.sch]
2015-05-05 exported images to facilitate version history understanding
    [Awesome-Shield-0.5.brd, Awesome-Shield-0.5.sch]
2015-05-05 partially updated photodiode part
    [Awesome-Shield-0.5.brd, Awesome-Shield-0.5.sch]
2015-05-05 finished updating photodiode part, updated thermistor part
    [Awesome-Shield-0.5.brd]
2015-05-05 updated RGB LED landing area
    [Awesome-Shield-0.5.brd]
2015-05-05 fixed inconsistencies between schematic and board, changed pot to correct layout, swapped sensor locations
    [Awesome-Shield-0.5.brd, Awesome-Shield-0.5.sch]
2015-05-05 added second resitor in series for red element of RGB LED, added 0603 resistors in parallel to 1206 ones for RGB LED
    [Awesome-Shield-0.5.brd, Awesome-Shield-0.5.sch]
2015-05-05 added smaller resistors in parallel for sensors
    [Awesome-Shield-0.5.brd, Awesome-Shield-0.5.sch]
2015-05-05 routed first few traces
    [Awesome-Shield-0.5.brd]
2015-05-06 added board outline on dimension layer
    [Awesome-Shield-0.5.brd]
2015-05-06 ripped up traces to start fresh
    [Awesome-Shield-0.5.brd]
2015-05-06 added ground pour
    [Awesome-Shield-0.5.brd]
2015-05-06 tweaked layout for routing starting point
    [Awesome-Shield-0.5.brd]
2015-05-06 partially routed
    [Awesome-Shield-0.5.brd]
2015-05-06 more routing, GND pour on bottom copper, began using bottom copper for routing
    [Awesome-Shield-0.5.brd, Awesome-Shield-0.5.sch]
2015-05-06 routing complete
    [Awesome-Shield-0.5.brd]
2015-05-06 routing actually complete
    [Awesome-Shield-0.5.brd]
2015-05-06 borrowed layout from branch CPvar1 but ripped nets
    [Awesome-Shield-0.5.brd]
2015-05-06 added ground pours back in, updated images which were wrong in last commit
    [Awesome-Shield-0.5.brd]
2015-05-06 completed routing traces for CPvar2
    [Awesome-Shield-0.5.brd]
2015-05-10 addd missing connections between resistor pads
    [Awesome-Shield-0.5.brd]
2015-05-10 nudged traces for better GND flood
    [Awesome-Shield-0.5.brd]
2015-05-11 redid layout for UI boost, ripped all traces
    [Awesome-Shield-0.5.brd]
2015-05-11 routed half the traces
    [Awesome-Shield-0.5.brd]
2015-05-11 finished routing traces, could use a good edit btu everything that should be is connected
    [Awesome-Shield-0.5.brd]
2015-05-11 small tweaks and optimizations
    [Awesome-Shield-0.5.brd]
2015-05-12 updated component locations and traces for better UX
    [Awesome-Shield-0.5.brd]
2015-05-12 trace tweaks for better ground pour covereage
    [Awesome-Shield-0.5.brd]
2015-05-13 fixed silkscreen to comply with DRC
    [Awesome-Shield-0.5.brd]
2015-05-13 gave vias more space around them
    [Awesome-Shield-0.5.brd]
2015-05-14 changed vias to round, powered potentiometer from IOREF instead of +3V3 power rail, trace and via tweaks
    [Awesome-Shield-0.5.brd, Awesome-Shield-0.5.sch]
2015-05-14 removed redundant vias, trace tweaks
    [Awesome-Shield-0.5.brd]
2015-05-14 removed redundant via, trace nudges for GND pour coverage
    [Awesome-Shield-0.5.brd]
2015-05-14 alligned solder bridge pads to make cutting them easier
    [Awesome-Shield-0.5.brd]
2015-05-14 small tweaks and silkscreen corrections for DRC
    [Awesome-Shield-0.5.brd]
2015-05-14 updated images
    [Awesome-Shield-0.5.brd]
2015-05-16 redid board layout to avoid touching USB and power housings
    [Awesome-Shield-0.5.brd]
2015-05-16 adjusted layout to fit smaller board
    [Awesome-Shield-0.5.brd]
2015-05-16 simplified bottom copper traces
    [Awesome-Shield-0.5.brd]
2015-05-18 changed to 4pin connectors to official ones from Grove library
    [Awesome-Shield-0.5.brd, Awesome-Shield-0.5.sch]
2015-05-18 updated 4pin connector silkscreens as per DRC
    [Awesome-Shield-0.5.brd, Awesome-Shield-0.5.sch]
2015-05-18 nudged traces, via, silk screen as per DRC
    [Awesome-Shield-0.5.brd]
2015-05-19 changed thermistor, photodiode, and potentiometer to be powered off IOREF
    [Awesome-Shield-0.5.brd, Awesome-Shield-0.5.sch]
2015-05-19 rerouted traces to match new ADC device circuits
    [Awesome-Shield-0.5.brd]
2015-05-20 ripped unnecessary 3V3 rail trace, nudged GND via
    [Awesome-Shield-0.5.brd]
2015-05-20 corrected pot circuit in schematic
    [Awesome-Shield-0.5.brd, Awesome-Shield-0.5.sch]
2015-05-20 corrected pot circuit on layout
    [Awesome-Shield-0.5.brd]
2015-05-20 switched locking headers board for normal headers board
    [Awesome-Shield-0.5.brd, Awesome-Shield-0.5.sch]
2015-05-20 adjusted X position of new board
    [Awesome-Shield-0.5.brd]
2015-05-20 made missing connection to A0 header
    [Awesome-Shield-0.5.brd]
2015-05-20 added router path to layer 45
    [Awesome-Shield-0.5.brd]
2015-05-20 changed router layer 46 to 1mm routing width, changed board outline to 0.001mm width, moved router path to cut with inside edge of path along board outline
    [Awesome-Shield-0.5.brd]
2015-05-20 changed resistor layout as per issue 11
    [Awesome-Shield-0.5.brd]
2015-05-21 changed component layout and redid routing because this branch diverged from the intended UX after commit 70255cb, roughly based component layout and UX intention off commit 70255cb
    [Awesome-Shield-0.5.brd]
2015-05-21 tidied up some traces
    [Awesome-Shield-0.5.brd]
2015-05-21 tweaks as per eagle default DRC
    [Awesome-Shield-0.5.brd]
2015-05-21 nudged tact and toggle switch locations
    [Awesome-Shield-0.5.brd]
2015-05-21 updated DRC to haka_35_l2 as per issue3
    [Awesome-Shield-0.5.brd]
2015-05-21 updated DRC to zwilling as per issue3
    [Awesome-Shield-0.5.brd]
2015-05-21 updated router layer to 2mm width, and aligned angled corners precisely
    [Awesome-Shield-0.5.brd]
2015-05-21 updated silkscreen with component names
    [Awesome-Shield-0.5.brd]
2015-05-21 added name and protype number to silkscreen
    [Awesome-Shield-0.5.brd]
2015-05-21 removed extraneous bits of traces, tidd traces
    [Awesome-Shield-0.5.brd]
2015-05-22 added toggle switch on and off position labels to silkscreen
    [Awesome-Shield-0.5.brd]
2015-05-22 remove ground loops, move inputs to the left edge WIP
    [Awesome-Shield-0.5.brd, Awesome-Shield-0.5.sch]
2015-05-22 turn buzzer, normalize space around LED
    [Awesome-Shield-0.5.brd]
2015-05-22 routing right half of the board
    [Awesome-Shield-0.5.brd]
2015-05-22 finished routing, no air wires left
    FIXME: grid placing not consistent, see pushbutton, expansion header
    etc.
    [Awesome-Shield-0.5.brd]
2015-05-22 add GND vias
    [Awesome-Shield-0.5.brd]
2015-05-22 change via sizes to .6mm, add micro fiducials
    [Awesome-Shield-0.5.brd, Awesome-Shield-0.5.sch]
2015-05-22 add a restriction rectangle to the top layer
    This is an example to give contrast at the small SMD parts. It reveals
    the traces with much more contrast and makes it easier to hand solder -
    less shorting, less thermal mass
    [Awesome-Shield-0.5.brd]
2015-05-23 removed big outline rectangle as per issue 18
    [Awesome-Shield-0.5.brd]
2015-05-23 changed board outline and major component locations to sit on mm grid
    [Awesome-Shield-0.5.brd]
2015-05-23 cleaning up traces and vias onto mm grid WIP
    [Awesome-Shield-0.5.brd]
2015-05-23 moved all vias onto mm grid
    [Awesome-Shield-0.5.brd]
2015-05-23 nudged large fiduciaries onto mm grid
    [Awesome-Shield-0.5.brd]
2015-05-23 removed redunant via
    [Awesome-Shield-0.5.brd]
2015-05-23 adjusted resistor keepout to sit on mm grid, added second resistor keepout for other resistor group
    [Awesome-Shield-0.5.brd]
2015-05-23 nudged microfiducials onto grid and placed some at component centers WIP, adjusted DRC to tent vias
    [Awesome-Shield-0.5.brd]
2015-05-23 adjusted router path and tab locations to fit board outline
    [Awesome-Shield-0.5.brd]
2015-05-23 changed all fonts to vector
    [Awesome-Shield-0.5.brd]
2015-05-23 added company, version, license info to bottom silkscreen
    [Awesome-Shield-0.5.brd]
2015-05-23 adjusted silkscreen component labels
    [Awesome-Shield-0.5.brd]
2015-05-23 adjusted bottom silk screen
    [Awesome-Shield-0.5.brd]
2015-05-23 adjusted fiducials as per issue 13
    [Awesome-Shield-0.5.brd, Awesome-Shield-0.5.sch]
2015-05-23 rerouted overlapping trace, m
    [Awesome-Shield-0.5.brd]
2015-05-24 fiducial placement now on a rectangular outline, silkscreen pulled away from the borders
    don't forget to add the commit hash to the board on the backside.
    [Awesome-Shield-0.5.brd, Awesome-Shield-0.5.sch]
2015-05-25 adjusted board height to 53mm
    [Awesome-Shield-0.5.brd]
2015-05-25 adjusted board outline placement to sit on 1mm grid
    [Awesome-Shield-0.5.brd]
2015-05-25 adjusted board width to 49mm as per issue 19
    [Awesome-Shield-0.5.brd]
2015-05-25 made space for soldering around buzzer and ports as per issue 21
    [Awesome-Shield-0.5.brd, Awesome-Shield-0.5.sch]
2015-05-25 realigned macro fiducials in rectangle on mm grid
    [Awesome-Shield-0.5.brd]
2015-05-25 nudged 4pin port micro fiducials to avoid annulus silk screen overlap
    [Awesome-Shield-0.5.brd]
2015-05-25 nudged GND vias
    [Awesome-Shield-0.5.brd]
2015-05-25 ajusted router path to fit board outline
    [Awesome-Shield-0.5.brd]
2015-05-25 specified LED resistor values, added logo to bottom silk screen
    [Awesome-Shield-0.5.brd, Awesome-Shield-0.5.sch]
2015-05-25 added resistor values for photodiode and thermistor, added resistor values to silkscreen
    [Awesome-Shield-0.5.brd, Awesome-Shield-0.5.sch]
2015-05-26 WIP making silkscreen text bigger, nudged components, moved pin labels to bottom silkscreen on shield part
    [Awesome-Shield-0.5.brd, Awesome-Shield-0.5.sch]
2015-05-26 WIP nudges to make silk screen type bigger
    [Awesome-Shield-0.5.brd]
2015-05-26 made silkscreen labels bigger, not yet DRC compliant WIP
    [Awesome-Shield-0.5.brd]
2015-05-26 fixed bottom and top silkscreen DRC issues
    [Awesome-Shield-0.5.brd]
2015-05-26 top silkscreen tweaks
    [Awesome-Shield-0.5.brd, Awesome-Shield-0.5.sch]
2015-05-26 updated photodiode to phototransistor, changed circuit, adjusted traces
    [Awesome-Shield-0.5.brd, Awesome-Shield-0.5.sch]
2015-05-26 removed incorrect trace
    [Awesome-Shield-0.5.brd]
2015-05-26 respecd light sensor resitors, increased silkscreen component font
    [Awesome-Shield-0.5.brd, Awesome-Shield-0.5.sch]
2015-05-27 updated LED resistor values as per issue 22
    [Awesome-Shield-0.5.brd, Awesome-Shield-0.5.sch]
2015-05-27 moved a via as per DRC, minor trace nudges
    [Awesome-Shield-0.5.brd]
2015-05-27 updated image
    [Awesome-Shield-0.5.brd]
2015-05-27 fixed airwire
    [Awesome-Shield-0.5.brd]
2015-05-28 consistent silkscreen spelling and better spacing
    [Awesome-Shield-0.5.brd]
2015-05-28 decrease thermal mass at temperature sensor
    [Awesome-Shield-0.5.brd]
2015-05-28 move registration mark from LED to correct corner
    also got rid of some local fiducials as the components are so big
    [Awesome-Shield-0.5.brd, Awesome-Shield-0.5.sch]
2015-05-28 m typo
    [Awesome-Shield-0.5.brd]
2015-05-28 centred right tab in router layer, added left tab in router layer as per issue 26
    [Awesome-Shield-0.5.brd]
2015-05-28 updated LED resistor values to 130 Ohm as per issue 22
    [Awesome-Shield-0.5.brd, Awesome-Shield-0.5.sch]
2015-05-28 adjusted resistor label silkscreen as per issue issue 25
    [Awesome-Shield-0.5.brd]
2015-05-29 updated branches, added BOM link
2015-06-09 added version number to bottom silk screen
    [Awesome-Shield-0.5.brd]
2015-06-10 changed photodiode to part with better availability and pricing
    [Awesome-Shield-0.5.brd, Awesome-Shield-0.5.sch]
2015-06-12 removed old outline from tDocu
    [Awesome-Shield-0.5.brd, Awesome-Shield-0.5.sch]
2015-06-12 adjusted pour outlines to fit boart outline
    [Awesome-Shield-0.5.brd]
2015-06-12 adjusted bottom copper pour to fit board outline
    [Awesome-Shield-0.5.brd]
2015-06-18 switched in new phototransistor
    [Awesome-Shield-0.5.brd, Awesome-Shield-0.5.sch]
2015-06-18 placed and routed phototransistor
    [Awesome-Shield-0.5.brd]
2015-06-18 nudged phototransistor silkscreen
    [Awesome-Shield-0.5.brd, Awesome-Shield-0.5.sch]
2015-06-18 silkscreen label dial to knob
    [Awesome-Shield-0.5.brd]
2015-06-18 M trace nudges and cleanup
    [Awesome-Shield-0.5.brd]
2015-06-23 changed silkscreen on photodiode to meet Seeed fusion specs, updated in part and updated part in design
    [Awesome-Shield-0.5.brd, Awesome-Shield-0.5.sch]
2015-06-23 moved temp label in silkscreen back from pad as per Seeed fusion specs
    [Awesome-Shield-0.5.brd]
2015-06-23 updated git repo URL
    [Awesome-Shield-0.5.brd]
2015-06-24 removed old unpanelized files
    [Awesome-Shield-0.5.brd, Awesome-Shield-0.5.sch]
2015-06-24 added panlized files in
    [Awesome-Shield-0.5.brd, Awesome-Shield-0.5.sch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]
2015-07-15 commmit hash wrong on silkscreen, removed tabs from panel outline
    [Awesome-Shield-0.50-0.51-Panelized-3x2.brd, Awesome-Shield-0.50-0.51-panelized-3-by-2.brd]
2015-07-19 changed GND via size as per issue 30
    [Awesome-Shield-0.5.brd]
2015-07-19 updated silk screen hashes to match prev commit 74005f51d368db7f3a47e446fe72189e79c3aaad, ready to order
    [Awesome-Shield-0.5.brd, Awesome-Shield-0.50-0.51-Panelized-3x2.brd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]
2015-07-28 corrected git hashes
    [Awesome-Shield-0.50-0.51-Panelized-3x2.brd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]
2015-11-20 rm thermistor
    [Awesome-Shield-0.5.brd, Awesome-Shield-0.5.sch]
2015-11-20 swapped out shield part for headers
    [Awesome-Shield-0.5.brd, Awesome-Shield-0.5.sch]
2015-11-20 clean up labels
    [Awesome-Shield-0.5.sch]
2015-11-20 exported gerbers
    [Awesome-Shield-0.5.GBL, Awesome-Shield-0.5.GBO, Awesome-Shield-0.5.GBP, Awesome-Shield-0.5.GBS, Awesome-Shield-0.5.GTL, Awesome-Shield-0.5.GTO, Awesome-Shield-0.5.GTP, Awesome-Shield-0.5.GTS]
2015-11-26 adjusted sch to make refdes more visible
    [Awesome-Shield-0.5.brd, Awesome-Shield-0.5.sch]
2015-11-26 added silkscreen labels for headers off board layout
    [Awesome-Shield-0.5.brd]
2015-11-26 added refdes labels for THT parts to silkscreen, image export broken - images out of date
    [Awesome-Shield-0.5.brd, Awesome-Shield-0.5.sch]
2015-12-03 reorganizing filetree for RFQ, added mounts and readme for RFQ
    [Awesome-Shield-0.5.GBL, Awesome-Shield-0.5.GBO, Awesome-Shield-0.5.GBP, Awesome-Shield-0.5.GBS, Awesome-Shield-0.5.GTL, Awesome-Shield-0.5.GTO, Awesome-Shield-0.5.GTP, Awesome-Shield-0.5.GTS]
2016-01-05 added missing specs to RFQ BoM
    [Bill of Materials.csv]
2016-03-22 RFQ update
    [Awesome-Shield-0.5.brd, Awesome-Shield-0.5.sch]
2016-07-04 repo cleanup prepping for v0.60
    [Awesome-Shield-0.5.brd, Awesome-Shield-0.5.sch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]
2016-07-24 fork to 0.6 for next batch production
    [Awesome-Shield-0.6.brd, Awesome-Shield-0.6.sch]
2016-07-24 schematic cosmetics, change Rs to 1206 footprint
    [Awesome-Shield-0.6.brd, Awesome-Shield-0.6.sch]
2016-07-24 change buzzer to Loudity t68-0808, sketch part
    [Awesome-Shield-0.6.brd, Awesome-Shield-0.6.sch]
2016-07-24 all components on imperial grid
    [Awesome-Shield-0.6.brd, Awesome-Shield-0.6.sch]
2016-07-24 LED data to D5 instead of D6
    [Awesome-Shield-0.6.brd, Awesome-Shield-0.6.sch]
2016-07-24 routing 90%, but to be stashed as components move again
    [Awesome-Shield-0.6.brd]
2016-07-24 no airwires left, GND established :shipit:
    [Awesome-Shield-0.6.brd, Awesome-Shield-0.6.sch]
2016-07-24 added large round silkscreen around LED, solved #31
    [Awesome-Shield-0.6.brd, Awesome-Shield-0.6.sch]
2016-07-24 m :shipit:
    [Awesome-Shield-0.6.brd]
2016-07-24 board preview at 852f0e5
2016-07-25 close #39 close #41 close #42
    [Awesome-Shield-0.6.brd, Awesome-Shield-0.6.sch]
2016-07-26 nudged components to provide more optimal spaces for labels in silkscreen
    [Awesome-Shield-0.6.brd]
2016-07-27 moved photodiode to make space for graphic
    [Awesome-Shield-0.6.brd]
2016-07-27 moved button to make more room for graphic
    [Awesome-Shield-0.6.brd]
2016-08-01 added git hash and version to bottom silkscreen, rendered gerbers, added top silkscreen as bitmap, added CAM job for gerber export
    [Awesome-Shield-0.6.brd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]
2016-08-03 updated drill files to excellon filetype
2016-08-29 added top silkscreen design to layer 201, aligned using outline on silkscreen layer WIP must remove board outline from 201 then remove contents of current tPlace then copy layer 201 contents to tPlace
    [Awesome-Shield-0.6.brd]
2016-08-31 added bottom silk screen design to layers 201 and 202 - WIP bPlace and tPlace must be cleaned up and updated using imported images on layers 200-202
    [Awesome-Shield-0.6.brd]
2016-09-01 moved custom graphics for top silkscreen to tPlace layer
    [Awesome-Shield-0.6.brd]
2016-09-01 aligned graphics in layer 202 with board outline
    [Awesome-Shield-0.6.brd]
2016-09-01 moved custom graphics for bottom silkscreen to bPlace layer
    [Awesome-Shield-0.6.brd]
2016-09-01 added 330R resistor to LED data line
    [Awesome-Shield-0.6.brd, Awesome-Shield-0.6.sch]
2016-09-01 moved via to avoid hole in silksreen
    [Awesome-Shield-0.6.brd]
2016-09-01 changed fiducials to Watterott standard 0.7mm
    [Awesome-Shield-0.6.brd, Awesome-Shield-0.6.sch]
2016-09-01 cleanup, version numbering update, image export of 4577046 - :shipit:
    [Awesome-Shield-1.0.brd, Awesome-Shield-1.0.sch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]
2016-09-02 nudged resistor
    [Awesome-Shield-1.0.brd]
2016-09-02 nudged LED C and R for component spacing :shipit:
    [Awesome-Shield-1.0.brd]
2016-09-02 passes Watterott DRC, exported image, :shipit:
    [Awesome-Shield-1.0.brd, Awesome-Shield-1.0.sch]
2016-09-02 added tPlace layer back into Gerber export, exported gerbers for production :shipit:
    [Awesome-Shield-1.0.GBL, Awesome-Shield-1.0.GBO, Awesome-Shield-1.0.GBS, Awesome-Shield-1.0.GTL, Awesome-Shield-1.0.GTO, Awesome-Shield-1.0.GTS]
2016-09-02 reorg, rm v0.5, add Bom & QC files - :shipit:
    [Awesome-Shield-0.5.GBL, Awesome-Shield-0.5.GBO, Awesome-Shield-0.5.GBP, Awesome-Shield-0.5.GBS, Awesome-Shield-0.5.GTL, Awesome-Shield-0.5.GTO, Awesome-Shield-0.5.GTP, Awesome-Shield-0.5.GTS]
2016-09-02 added PCB specs :shipit:
2016-09-05 add resistors to button, toggleSwitch, knob signal lines
    [Awesome-Shield-1.0.brd, Awesome-Shield-1.0.sch]
2016-09-06 adjusted silkscreen on resistors, passes watterott DRC - :shipit:
    [Awesome-Shield-1.0.brd, Awesome-Shield-1.0.sch]
2016-09-06 updated BoM with new resistors - :shipit:
    [Bill of Materials BoM.csv]
2016-09-06 updated Gerbers - :shipit:
    [Awesome-Shield-1.0.brd, Awesome-Shield-1.0.sch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]
2016-10-31 updated via size and made covered [Watterott]
    [Awesome-Shield-1.0.brd]
2016-10-31 updated gerber export job and exported gerbers :shipit:
    [Awesome-Shield-1.0.GBL, Awesome-Shield-1.0.GBS, Awesome-Shield-1.0.GTL, Awesome-Shield-1.0.GTS]
2016-11-02 updated drill export to EXCELLON
